chrs89/PCBA_IMUTAG_mini/README.md

# PCBA IMU Tag

A compact IMU tag PCB designed in KiCad.

## Preview

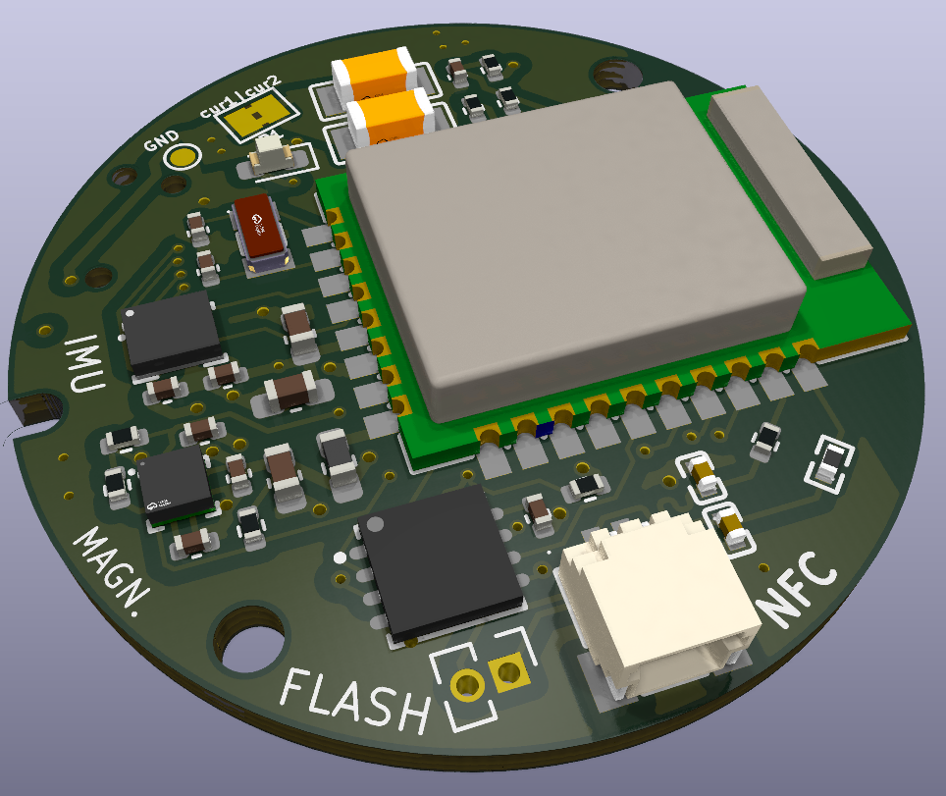
[picture p1: docs/pcba_render.png]
PCBA render


## Project files

- `*.kicad_pro` — KiCad project file
- `*.kicad_sch` — schematic
- `*.kicad_pcb` — PCB layout

## Status

Work in progress.
