chrs89/PCBA_IMUTAG_mini/imuTag.kicad_pcb

## KiCad design imuTag.kicad_pcb (2026-06-18)

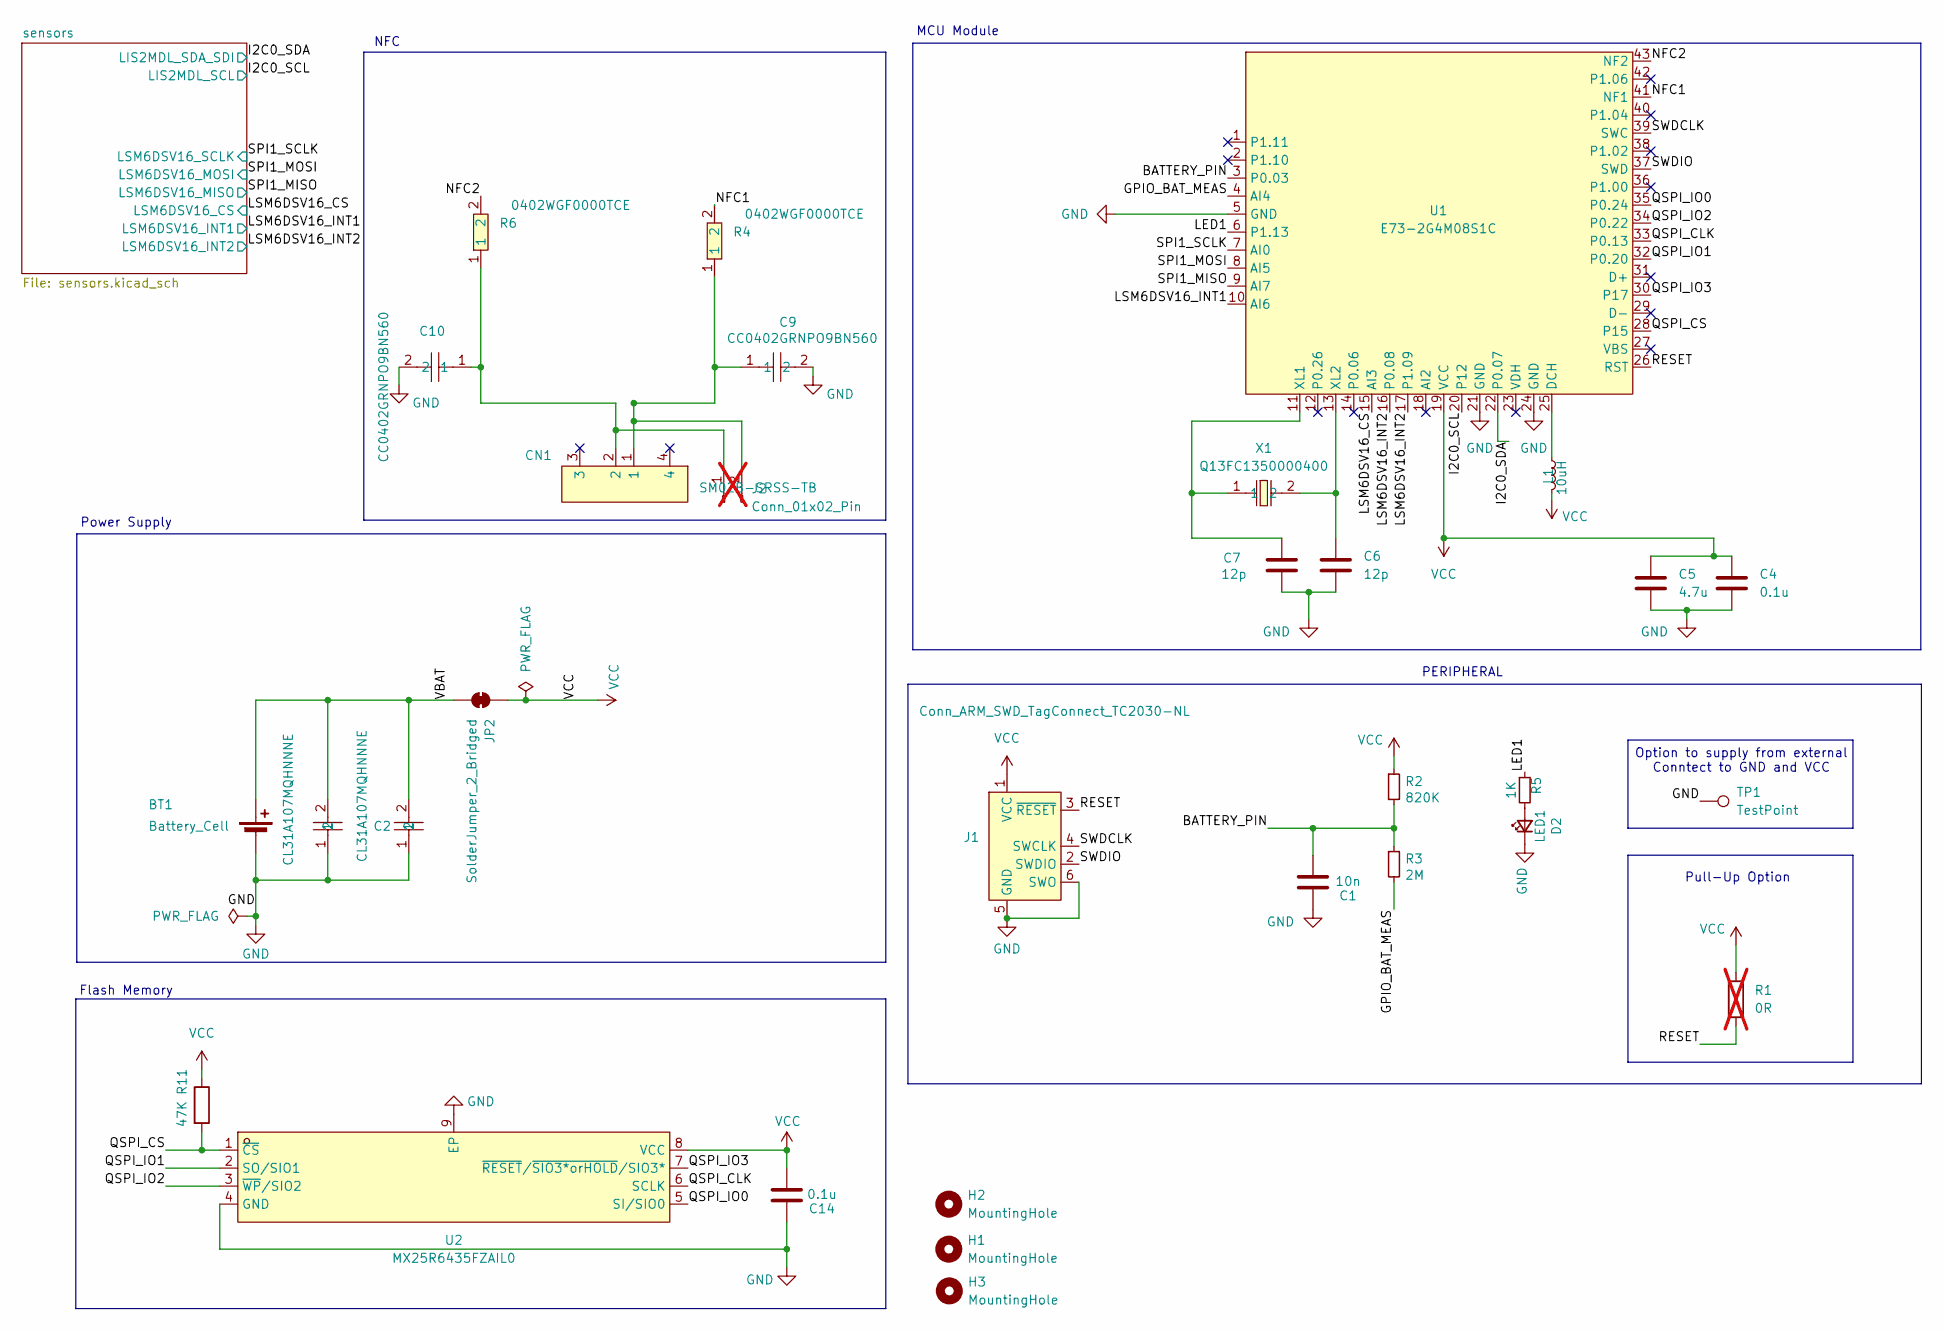
[picture p2: schematic imuTag.kicad_sch, IMU TAG]

Parts:
BT1: Battery_Cell; CR2032_Custom_Contacts_SMD_AirTagStyle
C1: 10n; C_0402_1005Metric
C2, C8: CL31A107MQHNNNE; C1206; MPN CL31A107MQHNNNE; LCSC Part C15008
C4: 0.1u; C_0603_1608Metric_Pad1.08x0.95mm_HandSolder
C5: 4.7u; C_0603_1608Metric
C6, C7: 12p; C_0402_1005Metric
C9, C10: CC0402GRNPO9BN560; C0402; MPN CC0402GRNPO9BN560; LCSC Part C526989
C14: 0.1u; C_0402_1005Metric
CN1: SM02B-SRSS-TB; CONN-SMD_2P-P1.00_SM02B-SRSS-TB-LF-SN; MPN SM02B-SRSS-TB(LF)(SN); LCSC Part C160402
D2: LED1; LED_0603_1608Metric_Pad1.05x0.95mm_HandSolder
H1, H3: MountingHole; MountingHole_2.1mm
H2: MountingHole; Slot_1.2x3.0mm_NPTH
J1: Conn_ARM_SWD_TagConnect_TC2030-NL; Tag-Connect_TC2030-IDC-NL_2x03_P1.27mm_Vertical
J2: Conn_01x02_Pin; PinHeader_1x02_P1.27mm_Vertical; not fitted
JP2: SolderJumper_2_Bridged; SolderJumper-2_P1.3mm_Bridged2Bar_Pad1.0x1.5mm
L1: 10uH; L_0603_1608Metric_Pad1.05x0.95mm_HandSolder
R1: 0R; R_0805_2012Metric_Pad1.20x1.40mm_HandSolder; not fitted
R2: 820K; R_0402_1005Metric
R3: 2M; R_0402_1005Metric
R4: 0402WGF0000TCE; R_0402_1005Metric; MPN 0402WGF0000TCE; LCSC Part C17168
R5: 1K; R_0402_1005Metric
R6: 0402WGF0000TCE; R0402; MPN 0402WGF0000TCE; LCSC Part C17168
R11: 47K; R_0402_1005Metric
TP1: TestPoint; TestPoint_Pad_D1.0mm
U1: E73-2G4M08S1C; WIRELM-SMD_E73-2G4M08S1C; MPN E73-2G4M08S1C; LCSC Part C356849
U2: MX25R6435FZAIL0; WSON-8_L4.0-W4.0-P0.80-BL-EP-1; MPN MX25R6435FZAIL0; LCSC Part C2802847
X1: Q13FC1350000400; FC-135R_L3.2-W1.5; MPN Q13FC13500004; LCSC Part C32346

Connections:
/BATTERY_PIN: C1.2, R2.2, R3.1, U1.3 (P0.03)
/GPIO_BAT_MEAS: R3.2, U1.4 (AI4)
/I2C0_SCL: U1.20 (P12); also elsewhere on the board
/I2C0_SDA: U1.22 (P0.07); also elsewhere on the board
/LED1: R5.1, U1.6 (P1.13)
/LSM6DSV16_CS: U1.15 (AI3); also elsewhere on the board
/LSM6DSV16_INT1: U1.10 (AI6); also elsewhere on the board
/LSM6DSV16_INT2: U1.16 (P0.08), U1.17 (P1.09); also elsewhere on the board
/NFC1: R4.2, U1.41 (NF1)
/NFC2: R6.2, U1.43 (NF2)
/QSPI_CLK: U1.33 (P0.13), U2.6 (SCLK)
/QSPI_CS: R11.2, U1.28 (P15), U2.1 (~CS)
/QSPI_IO0: U1.35 (P0.24), U2.5 (SI/SIO0)
/QSPI_IO1: U1.32 (P0.20), U2.2 (SO/SIO1)
/QSPI_IO2: U1.34 (P0.22), U2.3 (~WP/SIO2)
/QSPI_IO3: U1.30 (P17), U2.7 (~RESET/~SIO3*orHOLD/SIO3*)
/RESET: J1.3 (~RESET), R1.2, U1.26 (RST)
/SPI1_MISO: U1.9 (AI7); also elsewhere on the board
/SPI1_MOSI: U1.8 (AI5); also elsewhere on the board
/SPI1_SCLK: U1.7 (AI0); also elsewhere on the board
/SWDCLK: J1.4 (SWCLK), U1.39 (SWC)
/SWDIO: J1.2 (SWDIO), U1.37 (SWD)
/VBAT: BT1.1 (+), C2.2, C8.2, JP2.1 (A)
GND: BT1.2 (-), C1.1, C2.1, C4.2, C5.2, C6.2, C7.2, C8.1, C9.2, C10.2, C14.1, D2.1 (K), J1.5 (GND), J1.6 (SWO), TP1.1, U1.5 (GND), U1.21 (GND), U1.24 (GND), U2.4 (GND), U2.9 (EP); also elsewhere on the board
unnamed: D2.2 (A), R5.2
unnamed: C10.1, CN1.2, J2.1, R6.1
unnamed: C9.1, CN1.1, J2.2, R4.1
unnamed: L1.1, U1.25 (DCH)
unnamed: C7.1, U1.11 (XL1), X1.1
unnamed: C6.1, U1.13 (XL2), X1.2
VCC: C4.1, C5.1, C14.2, J1.1 (VCC), JP2.2 (B), L1.2, R1.1, R2.1, R11.1, U1.19 (VCC), U2.8 (VCC); also elsewhere on the board

Notes on the sheet:
MCU Module
Power Supply
Pull-Up Option
NFC
Flash Memory
Option to supply from external Conntect to GND and VCC
PERIPHERAL

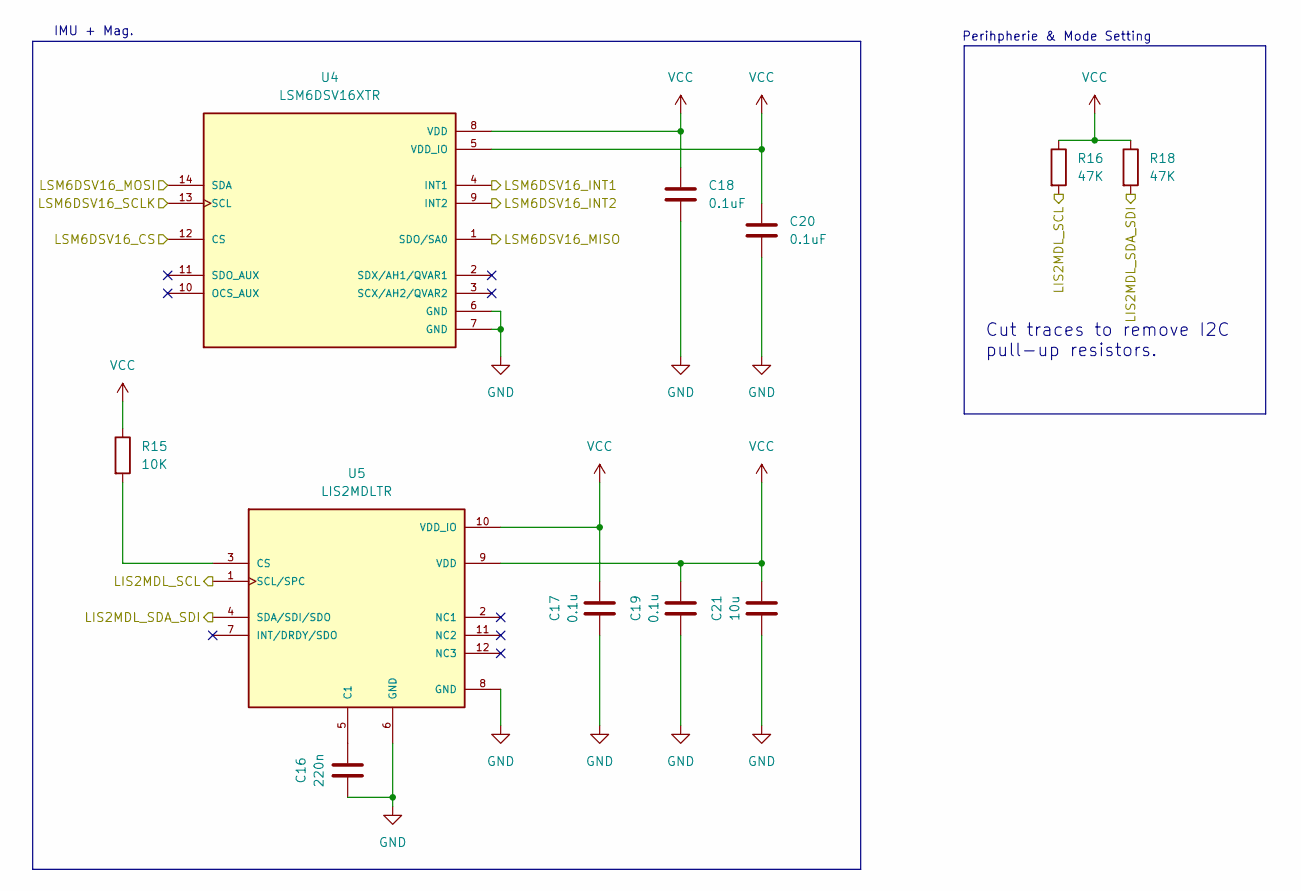
[picture p3: schematic sensors.kicad_sch]

Parts:
C16: 220n; C_0402_1005Metric
C17, C19: 0.1u; C_0402_1005Metric
C18, C20: 0.1uF; C_0402_1005Metric
C21: 10u; C_0603_1608Metric
R15: 10K; R_0402_1005Metric
R16, R18: 47K; R_0402_1005Metric
U4: LSM6DSV16XTR; LGA-14_L3.0-W2.5-P0.50-BR; PARTREV 4
U5: LIS2MDLTR; VLGA-12_L2.0-W2.0-P0.50-BL; PARTREV Rev 5

Connections:
/I2C0_SCL: R16.2, U5.1 (SCL/SPC); also elsewhere on the board
/I2C0_SDA: R18.2, U5.4 (SDA/SDI/SDO); also elsewhere on the board
/LSM6DSV16_CS: U4.12 (CS); also elsewhere on the board
/LSM6DSV16_INT1: U4.4 (INT1); also elsewhere on the board
/LSM6DSV16_INT2: U4.9 (INT2); also elsewhere on the board
/SPI1_MISO: U4.1 (SDO/SA0); also elsewhere on the board
/SPI1_MOSI: U4.14 (SDA); also elsewhere on the board
/SPI1_SCLK: U4.13 (SCL); also elsewhere on the board
GND: C16.1, C17.1, C18.2, C19.1, C20.2, C21.1, U4.6 (GND), U4.7 (GND), U5.6 (GND), U5.8 (GND); also elsewhere on the board
unnamed: C16.2, U5.5 (C1)
unnamed: R15.2, U5.3 (CS)
VCC: C17.2, C18.1, C19.2, C20.1, C21.2, R15.1, R16.1, R18.1, U4.5 (VDD_IO), U4.8 (VDD), U5.9 (VDD), U5.10 (VDD_IO); also elsewhere on the board

Notes on the sheet:
Cut traces to remove I2C pull-up resistors.
Perihpherie & Mode Setting
IMU + Mag.

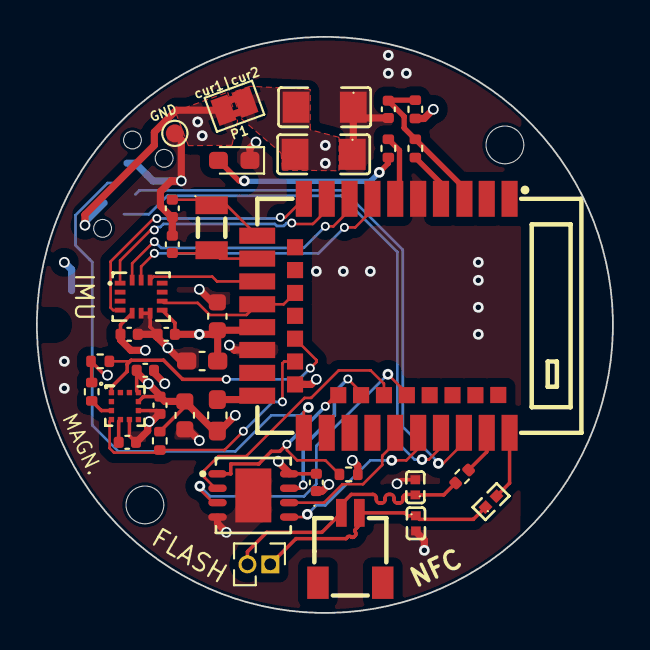
[picture p4: board imuTag.kicad_pcb from above]

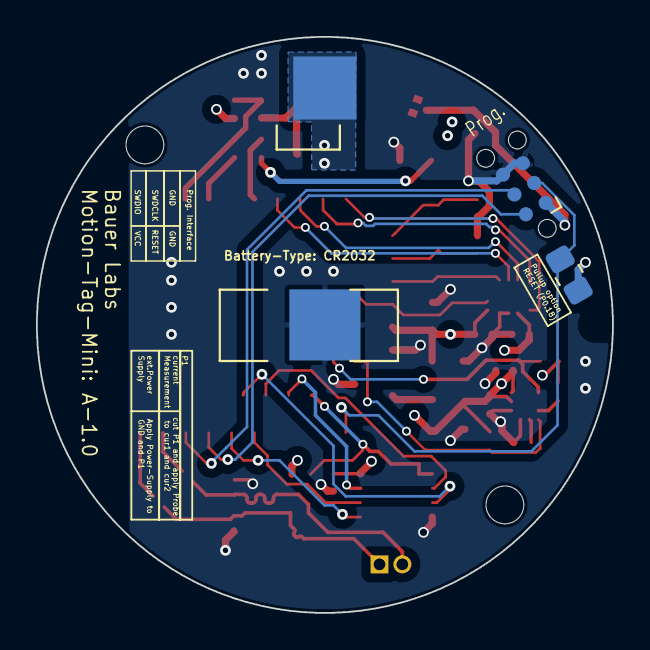
[picture p5: board imuTag.kicad_pcb from below]

Board: 4 copper layers, 32.0 x 32.0 mm, 42 parts (3 on the bottom side), 33 nets.
