chrs89/PCBA_IMUTAG_mini/(commit log)

2026-05-15 Initial KiCad PCB project IMU-Tag
    [imuTag.kicad_pcb, imuTag.kicad_sch, sensors.kicad_sch]
2026-05-15 Add README with PCBA image
2026-05-15 Add copper zones before routing
    [imuTag.kicad_pcb, imuTag.kicad_sch]
2026-05-15 Fix footprint DRC issues before routing
    [imuTag.kicad_pcb]
2026-05-15 Route power traces
    [imuTag.kicad_pcb, imuTag.kicad_sch]
2026-05-16 Optimize power path component arrangement
    [imuTag.kicad_pcb, imuTag.kicad_sch, sensors.kicad_sch]
2026-05-16 Routing of critical Paths, Finalizing Zones
    [imuTag.kicad_pcb, imuTag.kicad_sch]
2026-05-16 Route critical nets and finalize zones
    [imuTag.kicad_pcb]
2026-05-16 Save current QSPI routing cleanup
    [imuTag.kicad_pcb]
2026-05-16 finalize power routing and decoupling capacitors
    [imuTag.kicad_pcb]
2026-05-16 Save current routing work
    [imuTag.kicad_pcb]
2026-05-16 Ignore KiCad temporary files
2026-05-16 draw Important Tracks
    [imuTag.kicad_pcb, imuTag.kicad_sch, sensors.kicad_sch]
2026-05-16 Ignore generated KiCad and FreeRouting files
2026-05-16 Add autorouted PCB layout
    [imuTag.kicad_pcb]
2026-05-17 Complete routed PCB layout
    [imuTag.kicad_pcb]
2026-05-17 Finalize PCB for production
    [imuTag.kicad_pcb, imuTag.kicad_sch]
2026-05-17 Add 32 kHz crystal and load capacitors
    [imuTag.kicad_pcb, imuTag.kicad_sch]
2026-05-17 Add debug pins AI0 to AI4 to layout
    [imuTag.kicad_pcb, imuTag.kicad_sch]
2026-05-17 Update KiCad project local settings
2026-05-17 Update PCB layout
    [imuTag.kicad_pcb]
2026-05-17 updated pcba picture
2026-06-15 feat: imuTag mini PCBA v1.0 – initial release
    PCB layout, schematics (imuTag + sensors), custom EasyEDA symbol/footprint libraries with 3D models, design rules, and production outputs (BOM, placement, netlist).
    [bom.csv, designators.csv, imuTag.kicad_pcb, imuTag.kicad_sch, positions.csv, sensors.kicad_sch]
2026-06-15 feat: import Spectra auto-route session into PCB layout
    Applied Freerouting/Spectra session to imuTag.kicad_pcb, updating copper traces from the auto-router result.
    [imuTag.kicad_pcb]
2026-06-15 feat: finalize schematic wiring
    Completed all net connections across imuTag and sensors schematics. Design is electrically complete and ready for layout review.
    [imuTag.kicad_pcb]
2026-06-15 fix: minor wiring corrections under v1.2
    [imuTag.kicad_pcb]
2026-06-16 fix: wire unconnected pin and clear DRC exclusions
    [imuTag.kicad_pcb, imuTag.kicad_sch]
2026-06-17 feat: optimize LIS2MDL layout for magnetic integrity
    [imuTag.kicad_pcb]
2026-06-17 production: regenerate fabrication files for v1.3
    [bom.csv, designators.csv, positions.csv]
2026-06-17 chore: ignore production folder, untrack generated fab files
    [bom.csv, designators.csv, positions.csv]
2026-06-18 feat: add NFC antenna support via E73-2G4M08S1C
    - Add NFC matching network (ESD protection, 100pF tuning caps)
    - Add hybrid antenna connector (JST SH 1.0mm + hand-solder test pads)
    - Add 4-layer keepout zones around NFC traces and antenna feed
    - Route and length-balance NFC1/NFC2 traces
    [imuTag.kicad_pcb, imuTag.kicad_sch, sensors.kicad_sch]
2026-06-18 docs: update 3D render for v1.4 NFC antenna layout
